annoyedmilk/sallen-key-bp/Sallen-Key_Bandpass.docx

# Semesterarbeit

# Sallen-Key Bandpassfilter

# Erik Haubrich und Marco Müller

# 1. Vorwort

In der modernen Elektronik spielt die Filtertechnik eine entscheidende Rolle bei der Verarbeitung und Manipulation von Signalen. Filter werden verwendet, um unerwünschte Frequenzkomponenten zu unterdrücken und gewünschte Frequenzbereiche zu verstärken oder zu isolieren. Diese Werte wurden unter idealisierten Bedingungen berechnet und können in der Praxis abweichen.

Der Sallen-Key Bandpassfilter ist ein aktiver Filter, der sowohl Hoch- als auch Tiefpassfilterstufen kombiniert, um ein bestimmtes Frequenzband durchzulassen und alle anderen Frequenzen zu unterdrücken. Dieses Projekt zielt darauf ab, einen solchen Filter zu entwickeln.

Die folgende Arbeit beschreibt die schrittweise Entwicklung dieses Filters, beginnend mit der theoretischen Bestimmung der Übertragungsfunktionen, über die Dimensionierung und Simulation der Schaltung, bis hin zur praktischen Umsetzung und Vermessung. Ziel ist es, ein tiefgehendes Verständnis für die Funktionsweise und die Herausforderungen bei der Entwicklung von Sallen-Key Bandpassfiltern zu erlangen.

# 2. Inhaltsverzeichnis:

# 3. Aufgabenstellung

Mit Hilfe der nachfolgend abgebildeten Sallen-Key-Hoch- und Tiefpassfilter 3. Ordnung soll durch eine geeignete Zusammenschaltung ein Bandpassfilter entwickelt werden, welcher eine Grundverstärkung von A0 = 1 aufweist, die Frequenz fg = 50 kHz passieren lässt und alle andern möglichst gut dämpft. .

Die Welligkeit des Filters oder die Überhöhung bei der Grenzfrequenz soll 12 dB nicht überschreiten und der Filter soll eine hohe Impedanz-Wandlung aufweisen.

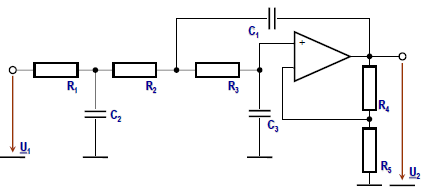
[picture p1: figure]
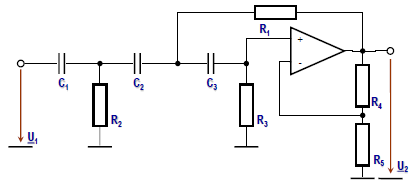
[picture p2: figure]

Abbildung 1: Sallen-Key Tiefpass 3. Ordnung | Abbildung 2: Sallen-Key Hochpass 3. Ordnung

## 3.1 Bestimmen der Übertragungsfunktionen f(p)

Für diesen Filter ist die Übertragungsfunktion der sekundärseitig leerlaufenden Schaltung in Abhängigkeit der Kreisfrequenz ω und der einzelnen Komponenten zu bestimmen.

f(p)=(U_2)/(U_1)|_(I_2 =0) =f(R_1 …R_5 ,C_1 …C_3 ,ω)

Formel 1: Übertragungsfunktion mit Abhängigkeiten

## 3.2 Dimensionieren der Schaltung

Anhand der in 3.1 errechneten Übertragungsfunktion soll der Filter nun so dimensioniert werden, dass er bei einer Grenzfrequenz von 50 kHz einen möglichst steil verlaufende Bandpasscharakteristik aufweist, wobei die Welligkeit maximal 6dB betragen soll. Die Grundverstärkung des Filters soll A0 = 1 sein. Es sind mehrere Varianten zu prüfen.

## 3.3 Darstellen der Übertragungsfunktion

Die in 3.1 errechneten Übertragungsfunktionen des in 3.2 dimensionierten Filters soll nach Bode in Amplituden und Phasengang dargestellt werden.

## 3.4 Simulation der Schaltung

Diese Schaltung soll mit einem geeigneten Werkzeug simuliert werden. Allfällige Abweichungen zu den Berechnungen sind zu begründen. Eine tiefere Analyse der Unterschiede zwischen Simulation und praktischen Ergebnissen sollte durchgeführt werden, um die Ursachen der Abweichungen zu identifizieren.

## 3.5 Stabilität der Schaltung

Anhand der Pol- und Nullstellen soll die Stabilität der Schaltung überprüft werden. Ansätze sind zu begründen.

## 3.6 Aufbauen und Ausmessen der Schaltung

Die Schaltung soll mit den in der Teilaufgabe 3.2 berechneten Bauteilen aufgebaut und ausgemessen werden. Allfällige Abweichungen zur in 3.3 berechneten Übertragungsfunktion sind zu begründen. Der Messaufbau und die Interpretation der Messresultate sind dahingehend zu konzipieren und zu automatisieren, dass daraus ein Testgerät entwickelt werden könnte.

## 3.7 Einschwingverhalten

Für den Bandpassfilter soll der Verlauf der Sprungantwort u2(t) berechnet und graphisch dargestellt werden. Zudem ist der Signalverlauf hinsichtlich der gewünschten Filterwirkung zu interpretieren.

# 4. Lösungsansatz

## 4.1 Bestimmen der Übertragungsfunktionen f(p)

Die in Abbildung 1 und Abbildung 2 gezeigten Schaltungen der 3. Ordnung können jeweils in eine Schaltung der ersten (Abbildung 3 und Abbildung 5) und zweiten (Abbildung 4 und Abbildung 6 ) Ordnung aufgeteilt werden. Das vereinfacht die Berechnungen und Definition der Bauteile.

### 4.1.1 Tiefpass 1. und 2. Ordnung

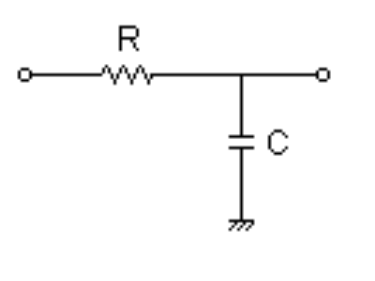
[picture p3: figure]
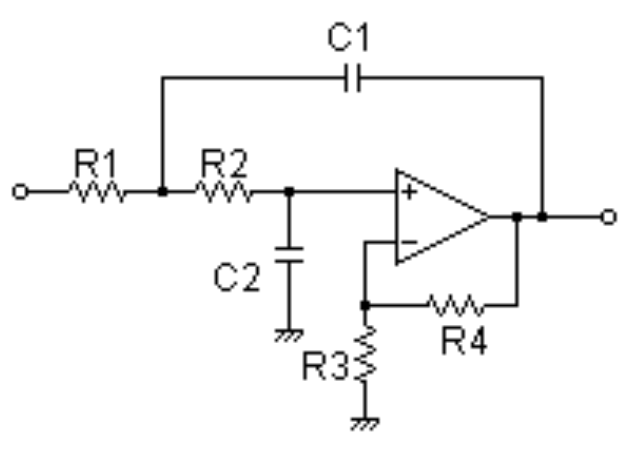
[picture p4: figure]

Abbildung 3: RC Tiefpass 1. Ordnung[^1] | Abbildung 4: Sallen-Key Tiefpassfilter 2. Ordnung¹

Die Übertragungsfunktionen für die Tiefpass-Filter sind in Formel 2 und Formel 3 dargestellt. Bei der Filterschaltung der ersten Stufe werden nur ein Widerstand und ein Kondensator verwendet. Für die zweite Stufe sind für das Filterverhalten R1, R2, C1 und C2 verantwortlich. R3 und R4 sind für die Verstärkung G der Operationsverstärkers (OP).

f(p)=(1/(C⋅R))/(s+1/(C⋅R))

Formel 2: RC Tiefpassfilter 1. Ordnung

f(p)=(G/(C_1 ⋅C_2 ⋅R_1 ⋅R_2))/(s^2 +s⋅1/(C_1 ⋅R_2)+s⋅1/(C_2 ⋅R_2)⋅(1-G)+1/(C_1 ⋅C_2 ⋅R_1 ⋅R_2))

Formel 3: Sallen-Key Tiefpassfilter 2. Ordnung

Gemäss den Grundgesetzen der Operationsverstärker ist die Verstärkung G in Formel 4 erläutert:

G=(R_3 +R_4)/(R_3)

Formel 4: Verstärkungsfaktor G

### 4.1.2 Hochpass 1. und 2. Ordnung

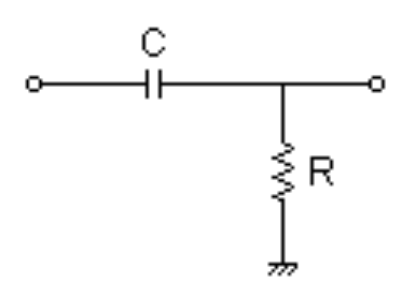
[picture p5: figure]
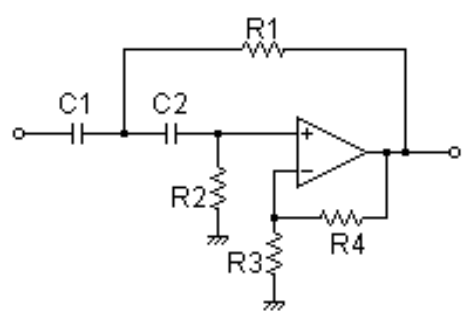
[picture p6: figure]

Abbildung 5: RC Hochpassfilter 1. Ordnung[^2] | Abbildung 6: Sallen-Key Hochpassfilter 2. Ordnung²

Wie auch beim Tiefpass erfüllen die Bauteile hier denselben Zweck. Die Übertragungsfunktionen für die Hochpass-Filter sind in Formel 5 und Formel 6 dargestellt.

f(p)=s/(s+1/(C⋅R))

Formel 5: RC Hochpassfilter 1. Ordnung

f(p)=(G⋅s^2)/(s^2 +s⋅1/(C_1 ⋅R_2)+s⋅1/(C_2 ⋅R_2)⋅+s⋅1/(C_1 ⋅R_1)⋅(1-G)+1/(C_1 ⋅C_2 ⋅R_1 ⋅R_2))

Formel 6: Sallen-Key Hochpassfilter 2. Ordnung

### 4.1.3 Filter 3. Ordnung

Durch die Multiplikation der Übertragungsfunktionen der ersten und der zweiten Stufe erhalten wir die Übertragungsfunktion der dritten Stufe (Formel 7 und Formel 8). Um die Übertragungsfunktion der gesamten Schaltung zu erhalten, müssen die beiden Übertragungsfunktionen der Filter der dritten Stufe miteinander multipliziert werden. Da diese sehr umfangreicht sind, habe wir sie hier nicht aufgeschrieben.

f(p)=(1/(C_1 ⋅C_2 ⋅C_3 ⋅R_1 ⋅R_2 ⋅R_3))/(s^3 +s^2 ⋅(1/(C_1 ⋅R_1)+1/(C_1 ⋅R_2)+1/(C_2 ⋅R_3)+1/(C_2 ⋅R_2))+s⋅(1/(C_2 ⋅C_3 ⋅R_2 ⋅R_3)+1/(C_1 ⋅C_2 ⋅R_2 ⋅R_3)+1/(C_1 ⋅C_2 ⋅R_1 ⋅R_3)+1/(C_1 ⋅C_2 ⋅R_1 ⋅R_2))+1/(C_1 ⋅C_2 ⋅C_3 ⋅R_1 ⋅R_2 ⋅R_3))

Formel 7: Sallen-Key Tiefpassfilter 3. Ordnung

f(p)=(s^3)/(s^3 +s^2 ⋅(1/(C_1 ⋅R_1)+1/(C_1 ⋅R_3)+1/(C_2 ⋅R_3)+1/(C_3 ⋅R_3))+s⋅(1/(C_1 ⋅C_2 ⋅R_1 ⋅R_3)+1/(C_1 ⋅C_3 ⋅R_1 ⋅R_3)+1/(C_1 ⋅C_3 ⋅R_2 ⋅R_3)+1/(C_2 ⋅C_3 ⋅R_2 ⋅R_3))+1/(C_1 ⋅C_2 ⋅C_3 ⋅R_1 ⋅R_2 ⋅R_3))

Formel 8: Sallen-Key Hochpassfilter 3. Ordnung

## 4.2 Dimensionieren der Schaltung

Durch die Wahl einer Chebyscheff-Charakteristik erhalten wir eine Überhöhung nahe der Grenzfrequenz. Das hat zur Folge, dass der 3dB-Punkt beim Tiefpass nach oben und beim Hochpass nach unten geschoben werden muss. Durch das Verfahren von Trial-and-Error konnten wir die Grenzfrequenzen der Filter bestimmen. Für den Tiefpass ergab sich eine Grenzfrequenz von 58,569 kHz, während für den Hochpass eine Frequenz von 43 kHz ermittelt wurde. Diese Werte sind unter optimalen Bedingungen anzunehmen. Durch die Wahl der Bauteile, unter Berücksichtigung der Wahl der Kondensatoren der E6-Reihe und die Wahl der Widerstände der E12-Reihe, werden diese Werte leicht verändert werden.

Mithilfe des Rechners auf der Seite okawa-denshi.jp[^3] haben wir folgende Werte erhalten.

Tiefpass 1. Ordnung (Abbildung 3): R = 82Ω und C = 33nF

Tiefpass 2. Ordnung (Abbildung 4): R1 = 820Ω, R2 = 270Ω, R3 = 10Ω, R4 = 6.8Ω, C1 = 15nF und C2 = 2.2nF

Hochpass 1. Ordnung (Abbildung 5): R = 47Ω und C = 68nF

Hochpass 2. Ordnung (Abbildung 6): R1 = 220Ω, R2 = 1kΩ, R3 = 10Ω, R4 = 6.8Ω, C1 = 6.8nF und C2 = 6.8nF

## 4.3 Darstellen der Übertragungsfunktion

### 4.3.1 Tiefpass

In Abbildung 7 und Abbildung 8 werden die Amplituden- und Phasengänge der Tiefpassstufen dargestellt. Es sind die zu erwarteten Charakteristika zu erkennen.

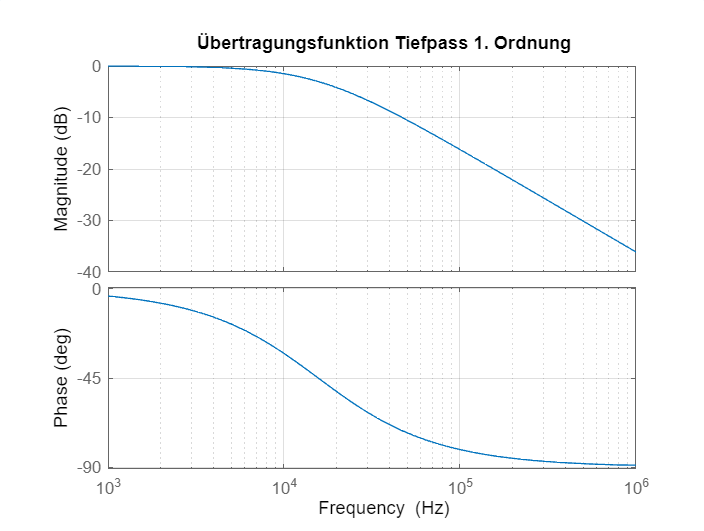
[picture p7: figure]
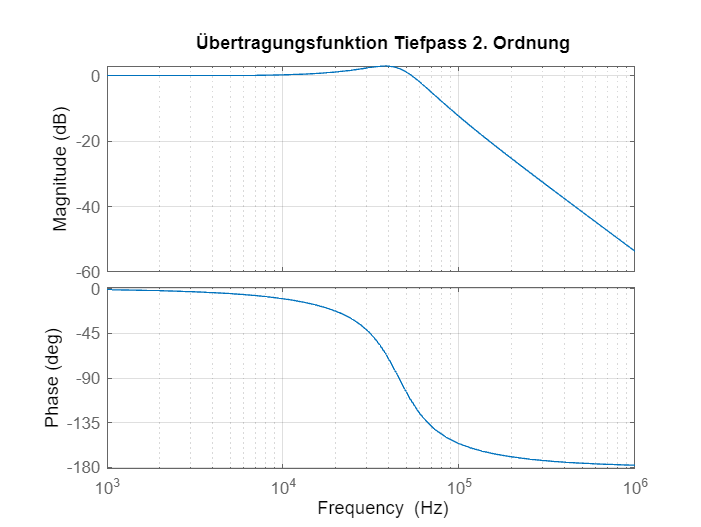
[picture p8: figure]

Abbildung 7: Amplituden- und Phasengang TP 1. Ordnung | Abbildung 8: Amplituden- und Phasengang TP 2. Ordnung

Durch die Multiplikation der zwei Tiefpassfilter erhalten wir in Abbildung 9 den Amplituden- und Phasengang der dritten Ordnung, welche eine Chebyscheff-Charakteristik aufweist.

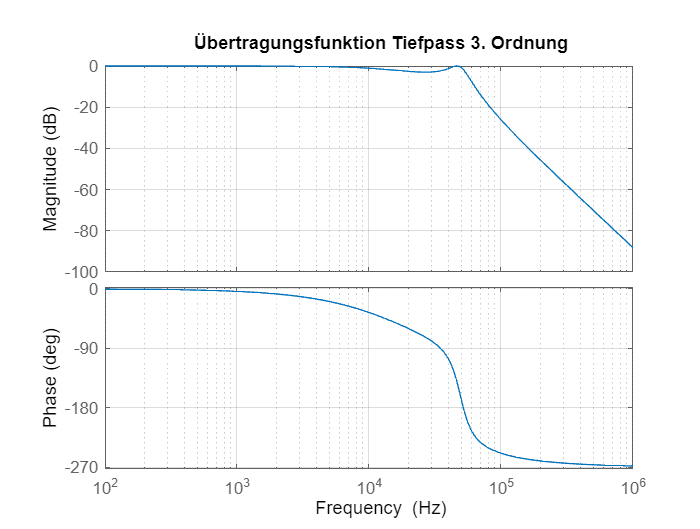
[picture p9: figure]

Abbildung 9: Amplituden- und Phasengang TP 3. Ordnung

### 4.3.2 Hochpass

In Abbildung 7, Abbildung 10 und Abbildung 11 werden die Amplituden- und Phasengänge der Hochpassstufen dargestellt. Es sind auch hier die zu erwarteten Charakteristika zu erkennen.

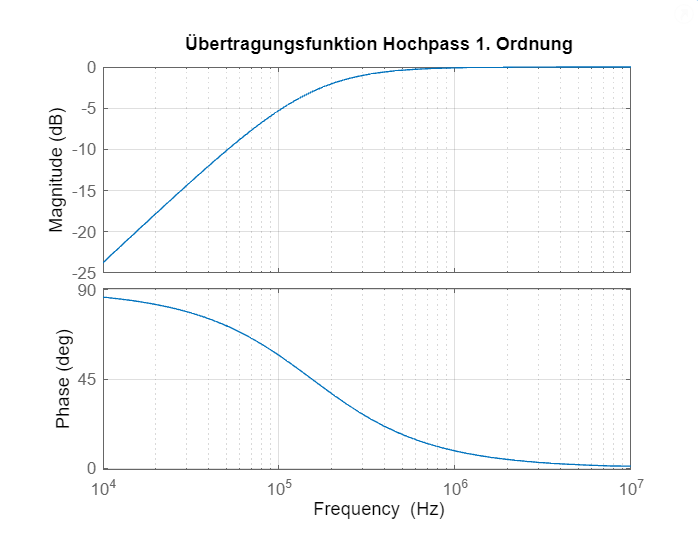
[picture p10: figure]
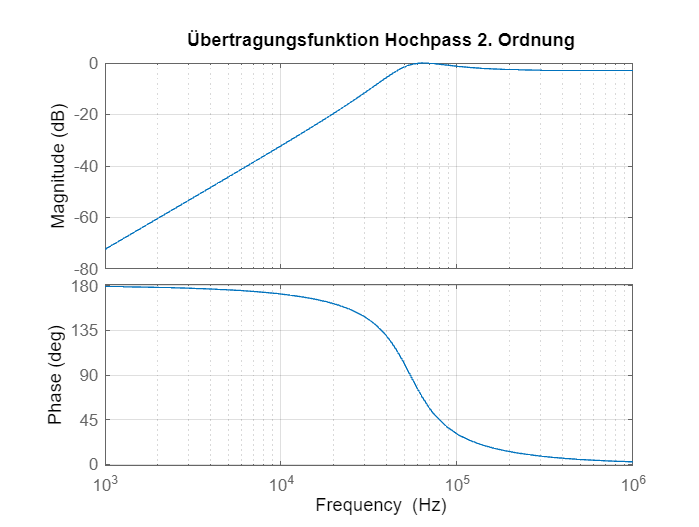
[picture p11: figure]

Abbildung 10: Amplituden- und Phasengang HP 1. Ordnung | Abbildung 11: Amplituden- und Phasengang HP 2. Ordnung

Durch die Multiplikation der zwei Hochpassfilter erhalten wir in Abbildung 12 den Amplituden- und Phasengang der dritten Ordnung, welche eine Chebyscheff-Charakteristik aufweist.

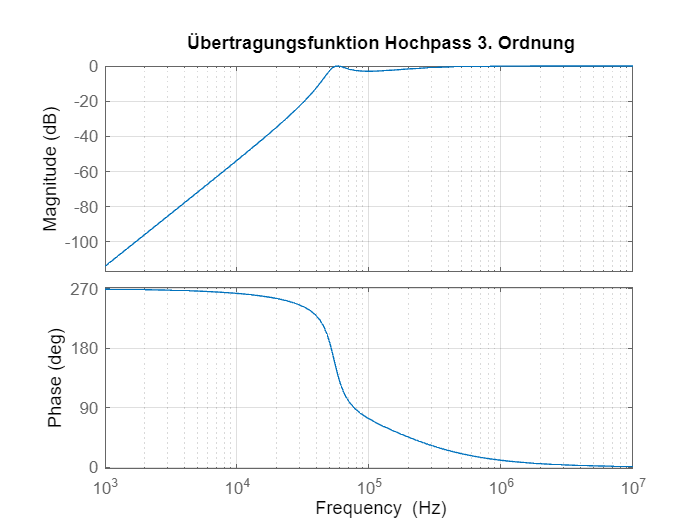
[picture p12: figure]

Abbildung 12: Amplituden- und Phasengang HP 3. Ordnung

Abbildung 12 zeigt den Amplituden- und Phasengang des Hochpassfilters 3. Ordnung. Die obere Grafik stellt die Magnitude in Dezibel (dB) dar, während die untere Grafik den Phasengang in Grad (deg) zeigt. Der Frequenzgang verläuft über mehrere Dekaden auf der x-Achse in Hertz (Hz). Der Amplitudengang zeigt eine steil ansteigende Charakteristik, während der Phasengang eine Verschiebung von 270 Grad aufweist. Diese Darstellung bestätigt die erwartete Filtercharakteristik und zeigt, dass der Hochpassfilter Frequenzen oberhalb der Grenzfrequenz effektiv durchlässt und darunter liegende Frequenzen dämpft.

### 4.3.3 Bandpass

Nachdem wiederum die gesamten Übertragungsfunktionen der Tief- und Hochpassfilter miteinander multipliziert werden, entsteht die Gesamtübertragungsfunktion, deren Amplituden- und Phasengang in Abbildung 13 grafisch dargestellt werden.

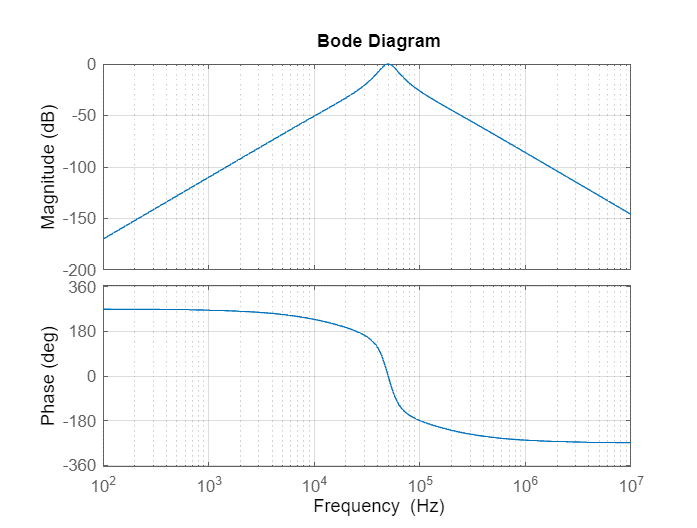
[picture p13: figure]

Abbildung 13: Amplituden- und Phasengang BP 6. Ordnung

Abbildung 13 zeigt das Bode-Diagramm des Bandpassfilters 6. Ordnung. Die obere Grafik stellt die Magnitude in Dezibel (dB) dar, während die untere Grafik den Phasengang in Grad (deg) zeigt. Der Frequenzbereich erstreckt sich von 10^2 Hz bis 10^7 Hz. Der Amplitudengang weist eine signifikante Spitze bei der Mittenfrequenz von 50 kHz auf, was die gewünschte Bandpasscharakteristik bestätigt. Der Phasengang zeigt eine kontinuierliche Phasenverschiebung, die typisch für Filter dieser Ordnung ist. Aus dem Graph ist weiter zu erkennen, dass die angestrebte Mittenfrequenz von 50 kHz mit einer Verstärkung von 0 dB eingehalten wird.

## 4.4 Simulation der Schaltung

Anhand des Messaufbaus in der Spice-Software (Abbildung 14) konnten wir die vorhergehenden MATLAB Berechnungen verifizieren. Die Ergebnisse theoretischer Natur sind in Abbildung 15 und Abbildung 16 verglichen und stimmen sehr gut überein.

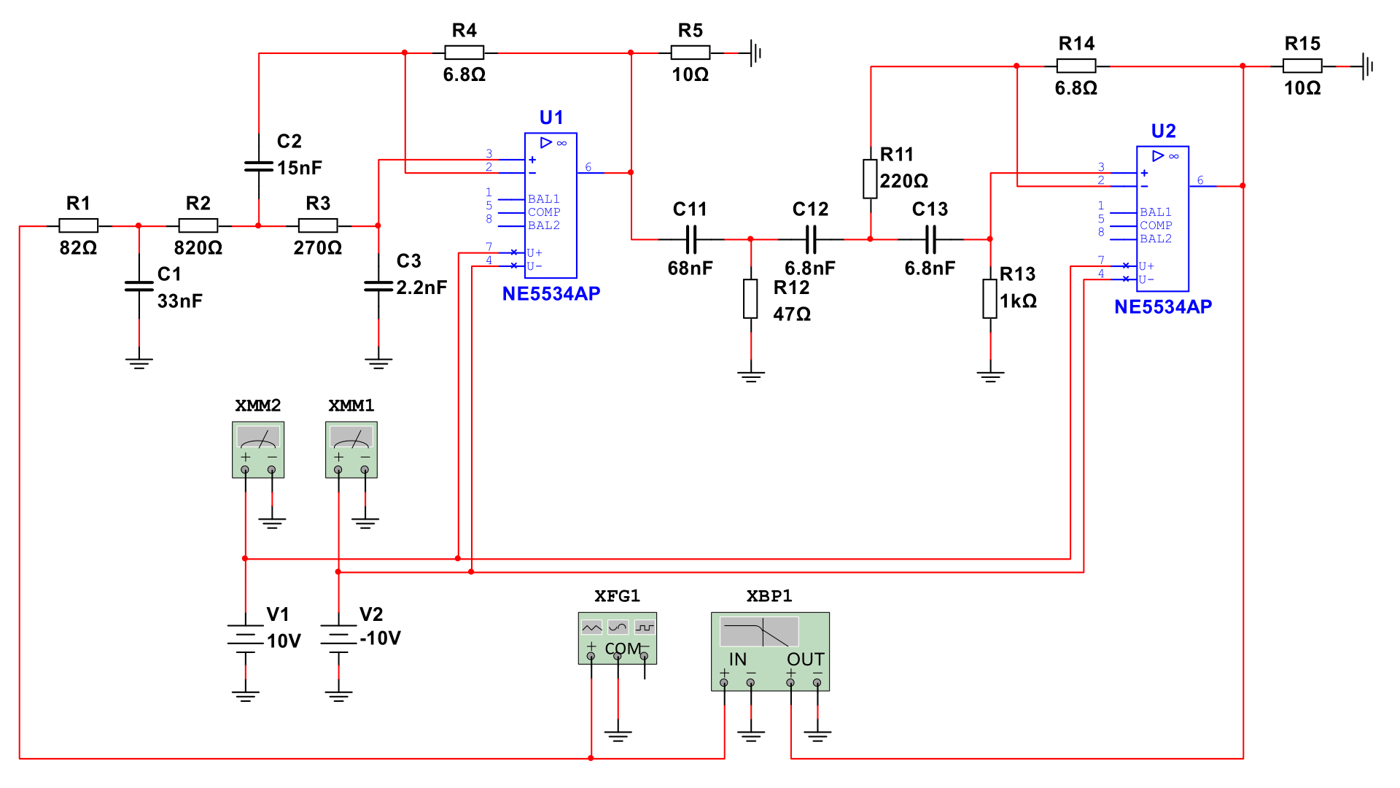
[picture p14: figure]

Abbildung 14: Aufbau Simulation

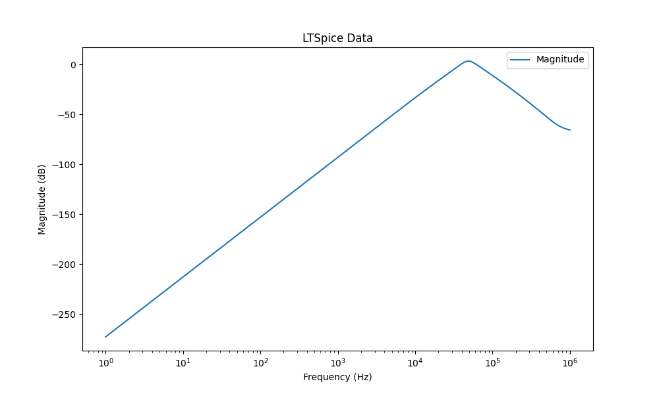
[picture p15: figure]
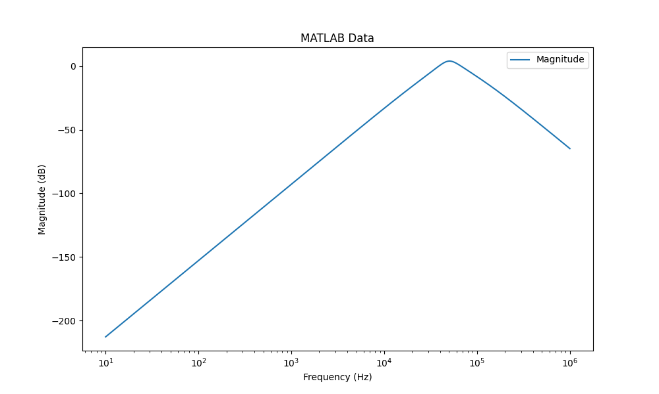
[picture p16: figure]

Abbildung 15: Spice-Plot | Abbildung 16: MATLAB-Plot

## 4.5 Stabilität der Schaltung

Aus den Lehren zu den Pol- und Nullstellen zum Ermitteln der Stabilität der Schaltung sehen wir, dass unsere Schaltung mit hoher Wahrscheinlichkeit stabil laufen wird, da sich die Polstellen im zweiten und dritten Quadranten befinden (Abbildung 17). Dies wird sich mit dem Einschwingverhalten bestätigen (4.8).

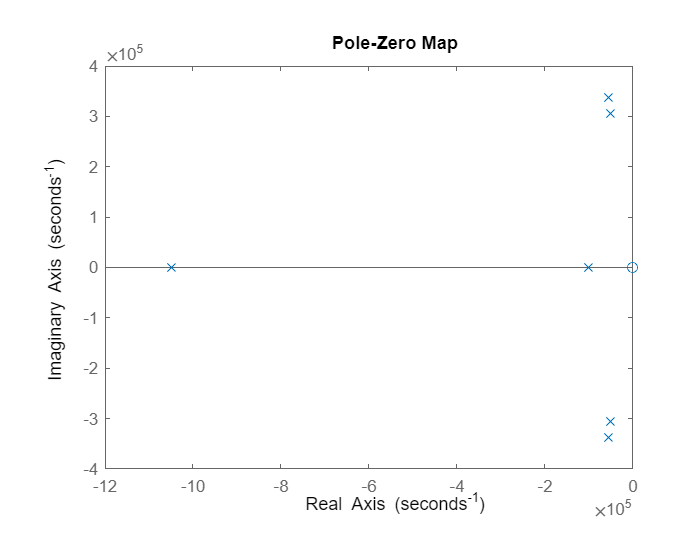
[picture p17: figure]

Abbildung 17: Pol- und Nullstellen BP 6. Ordnung

Abbildung 17 zeigt die Pol-Nullstellen-Karte (Pole-Zero Map) des entwickelten Bandpassfilters. Die Polstellen befinden sich alle in der linken Halbebene, was darauf hinweist, dass das System stabil ist. Die Symmetrie der Pole entlang der imaginären Achse unterstützt diese Stabilitätsbewertung zusätzlich.

## 4.6 Aufbauen und Ausmessen der Schaltung

Der Messaufbau (Abbildung 18) wurde auf einer Lochrasterplatine realisiert. Hier ist der Aufbau nicht optimal, da sehr viele Störeinflüsse die Funktion beeinflussen können. Um die Schaltung für den realen Einsatz zu bauen, wäre es nötig ein PCB korrekt zu layouten. Die Messungen wurden noch mit früher dimensionierten Bauteilen für den Tiefpass durchgeführt. Da haben wir sehr kleine Kapazitäten verwendet, was zur Folge hat, dass Streukapazitäten einen negative Einfluss haben.

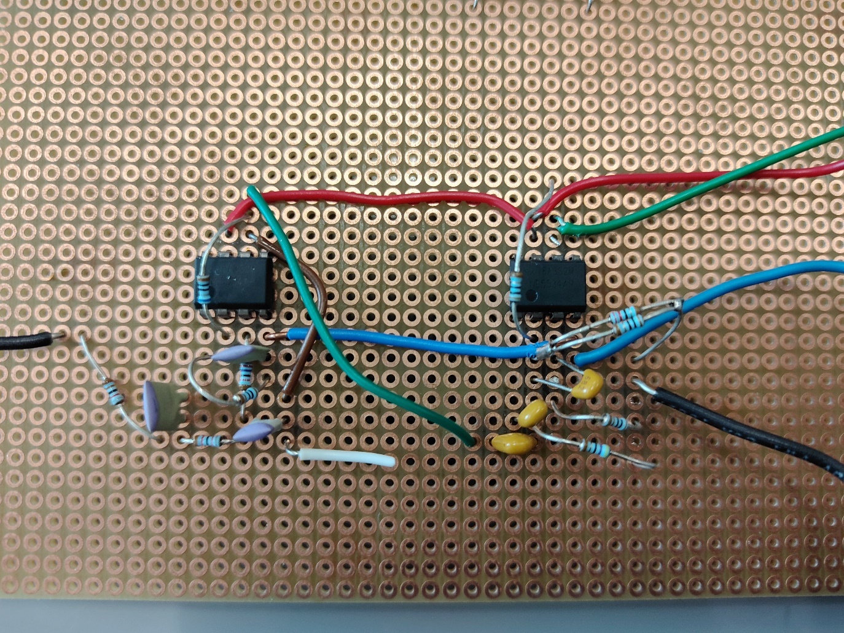
[picture p18: figure]

Abbildung 18: Messaufbau Bandpass

Um die Schaltung auszumessen wurden die OPs mit ±5V versorgt und ein Signal von 1Vpp eingespiesen und ein AC-Sweep durchgeführt.

Das Messresultat ergibt, dass wir trotz schlechtem Aufbau und unerwünschten Einflüssen die gewünschte Filtercharakteristik nahe der angestrebten Frequenz erhalten haben und die vorgegebene Überhöhung von 12dB nicht überschreiten (Abbildung 19). Die Störeinflüsse sind dadurch zu erkennen, dass wir ein hohes Rauschmass auf dem gefilterten Signal haben. Der höchste Punkt des Signals ist abgetrennt, weil wir für die Messung eine Speisung von ±5V gewählt haben. Um die Abtrennung der Spitzen zu verhindern, muss die Betriebsspannung des OPs erhöht werden, auf beispielsweise ±12V.

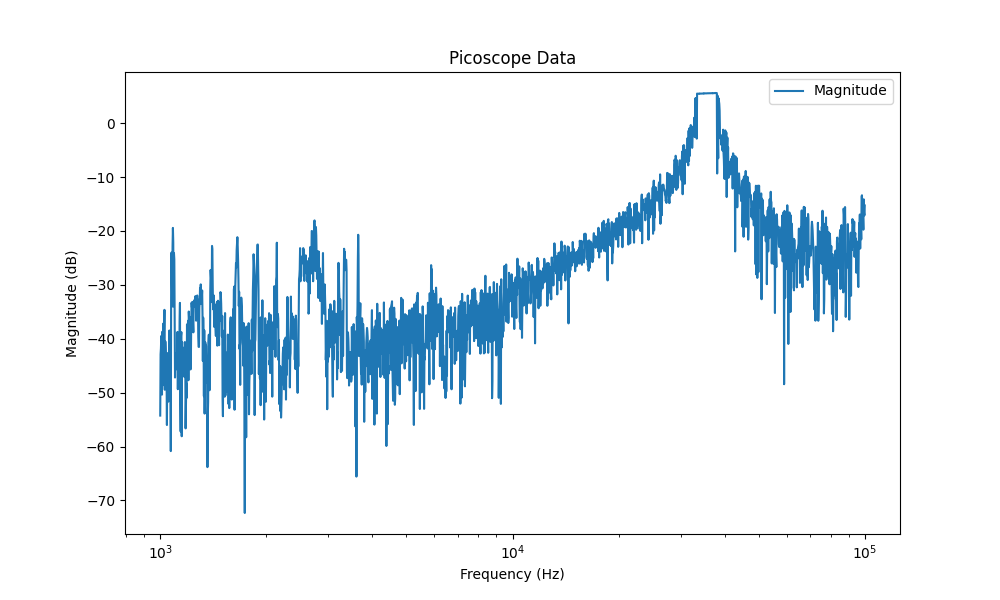
[picture p19: figure]

Abbildung 19: Messung des Aufbaus

Abbildung 19 zeigt den Frequenzgang des aufgebauten Bandpassfilters, gemessen mit einem PicoScope. Die y-Achse stellt die Magnitude in Dezibel (dB) dar und die x-Achse die Frequenz in Hertz (Hz). Es ist eine signifikante Spitze bei etwa 50 kHz zu erkennen, was darauf hinweist, dass der Bandpassfilter bei dieser Frequenz am stärksten verstärkt. Die unregelmässigen Ausschläge und das Rauschen im unteren Frequenzbereich deuten auf Störeinflüsse oder Messungenauigkeiten hin, die durch den suboptimalen Messaufbau auf einer Lochrasterplatine verursacht werden könnten.

## 4.7 Vergleich der Messung und Simulation

In Abbildung 20 werden Ergebnisse aus den Berechnungen in MATLAB, der Simulation in LTspice und dem praktischen Aufbau verglichen. Es ist zu erkennen, dass die Berechnungen und die Simulation übereinstimmen, jedoch weist der praktische Aufbau Abweichungen sowie Rauschen auf. Dies ist auf den unzureichenden Aufbau und den negativen Einflüssen der Streukapazitäten beim Tiefpass zurückzuführen.

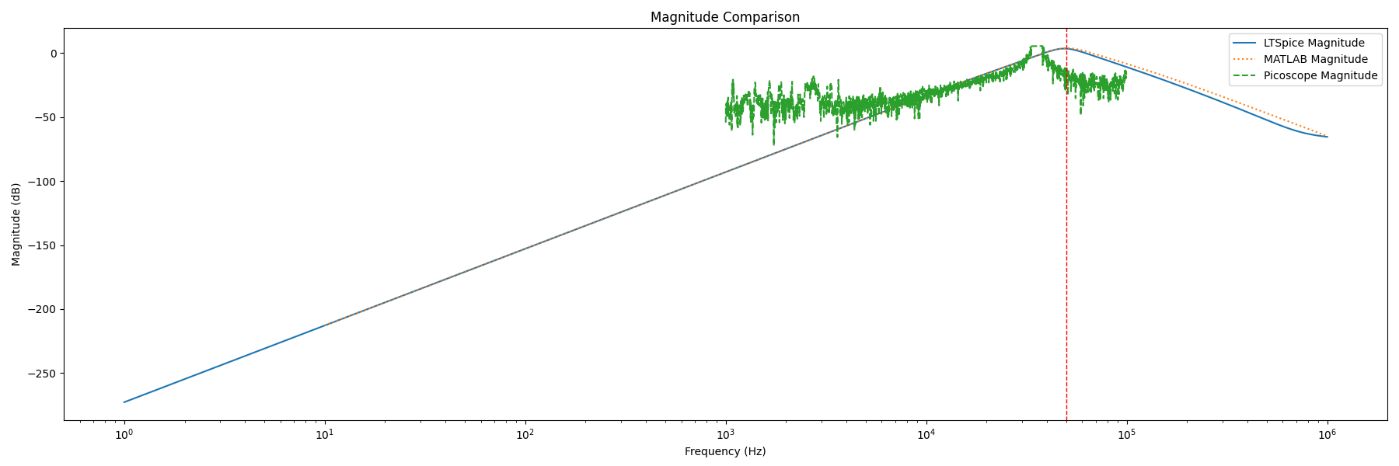
[picture p20: figure]

Abbildung 20: Vergleich LTspice, MATLAB, PicoScope

## 4.8 Einschwingverhalten

Das Einschwingverhalten in Abbildung 21 lässt erkennen, dass diese Schaltung mit den definierten Bauteilwerten nach ungefähr 1.4 Sekunden recht stabil läuft. Das bestätigt die Annahme aus den Erkenntnissen des Pol- und Nullstellengraphs (4.5).

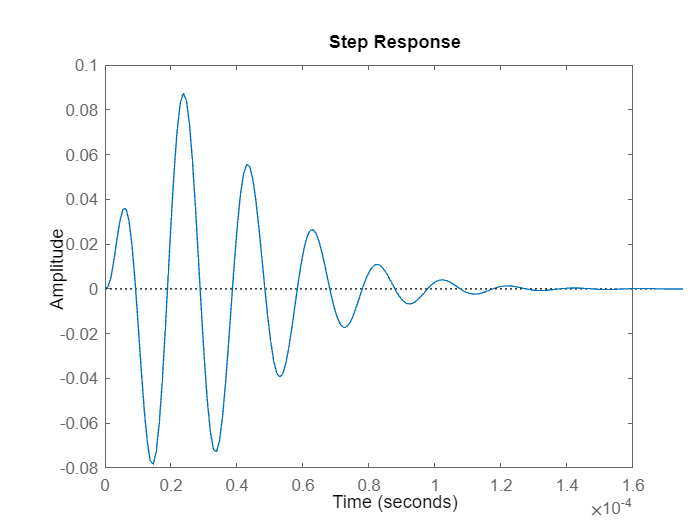
[picture p21: figure]

Abbildung 21: Einschwingverhalten BP 6. Ordnung

## 4.9 Fazit

Im Rahmen dieses Projekts wurde ein Sallen-Key Bandpassfilter entwickelt, simuliert und praktisch umgesetzt. Durch die detaillierte Bestimmung der Übertragungsfunktionen, die sorgfältige Dimensionierung der Bauteile und die anschliessende Simulation konnten die theoretischen Grundlagen gefestigt und in der Praxis angewendet werden.

Die Simulationen mit LTspice und MATLAB zeigten eine gute Übereinstimmung mit den theoretischen Berechnungen. Dies unterstreicht die Genauigkeit und Zuverlässigkeit der durchgeführten Dimensionierung und der gewählten Methodik. Die praktische Umsetzung des Filters auf einer Lochrasterplatine offenbarte jedoch Herausforderungen, insbesondere durch Störeinflüsse und Streukapazitäten, die in einer professionellen PCB-Umsetzung minimiert werden könnten.

Trotz der suboptimalen Bedingungen des Messaufbaus konnte die gewünschte Filtercharakteristik weitgehend erreicht werden. Die Messungen bestätigten, dass die angestrebte Mittenfrequenz von 50 kHz eingehalten und die maximale Überhöhung von 12 dB nicht überschritten wurde. Dies zeigt, dass die grundlegende Funktionsweise des Filters korrekt ist, auch wenn Verbesserungen in der Umsetzung notwendig sind.

Zusammenfassend lässt sich sagen, dass das Projekt erfolgreich die Entwicklung eines Sallen-Key Bandpassfilters demonstriert hat. Die Kombination aus theoretischen Berechnungen, Simulationen und praktischen Messungen ermöglichte ein umfassendes Verständnis der Filtercharakteristik und der Herausforderungen bei der Umsetzung. Für zukünftige Projekte wird empfohlen, die Implementierung auf einer professionellen Platine zu realisieren, um Störeinflüsse zu minimieren und die Performance des Filters weiter zu verbessern.

# 5. Anhang

## 5.1 Abbildungsverzeichnis

## 5.2 Formelverzeichnis

## 5.3 Verweise

http://sim.okawa-denshi.jp/en/Fkeisan.htm. (2024).

## 5.4 Verwendete Werkzeuge

PicoScope 2204A SN: JO243/1412

MATLAB R2022b

LTspice V17.2.4 for MacOS

NI Multisim 14.1

[^1] (http://sim.okawa-denshi.jp/en/Fkeisan.htm, 2024)
[^2] (http://sim.okawa-denshi.jp/en/Fkeisan.htm, 2024)
[^3] (http://sim.okawa-denshi.jp/en/Fkeisan.htm, 2024)

2 Semesterarbeit IKT1 Sallen-Key Bandpassfilter TS TSE 2202A Autor: Erik Haubrich und Marco Müller Juventus Technikerschule HF

www.technikerschule.ch
