annoyedmilk/sallen-key-bp/(list of files, drawings)

Other design files:
MultiSim/SallenKey_BP.ms14
