annoyedmilk/sallen-key-bp/(commit log)

2024-03-12 Init Multisim
    [SallenKey_BP.ms14]
2024-03-12 Update to E6-Values
    [SallenKey_BP.ms14]
2024-03-12 update
    update
    [outputsallen-key-tp.csv]
2024-05-20 Updated python script
    Create python venv and make a new comaprison script for Matlab and LTSpice
    [Matlab-Simualtion.csv]
2024-06-08 Vorwort und Layout angepasst
2024-06-11 Add Messaufbau
    [SallenKey_BP.ms14]
